juper007/radxa-zero3w-robot-hat/production/README.md

# Production

Manufacturing outputs will be stored here only after the corresponding design revision passes pre-fabrication review.

Planned outputs:

- `gerber/` - Gerber and drill files
- `bom/` - BOM exports with manufacturer part numbers
- `assembly/` - pick-and-place, assembly drawings and build notes

Every manufacturing package must state the exact design revision and commit used to generate it.
