juper007/radxa-zero3w-robot-hat/hardware/kicad/dynamixel_v17_import.sch

## KiCad design hardware/kicad/dynamixel_v17_import.sch (2026-09-10)

Schematic: dynamixel_v17_import.sch

Parts:
C_U5, C_U6, C_U7: 100n; C_0402_1005Metric
J_DXL_A: DYNAMIXEL_A; JST_EH_B3B-EH-A_1x03_P2.50mm_Vertical
J_DXL_B: DYNAMIXEL_B; JST_EH_B3B-EH-A_1x03_P2.50mm_Vertical
J_DXL_C: DYNAMIXEL_C; JST_EH_B3B-EH-A_1x03_P2.50mm_Vertical
J_IMU_DXL: IMU_TO_DXL; JST_EH_B3B-EH-A_1x03_P2.50mm_Vertical
Q1: MMBT3906; SOT-23
R26, R27, R31, R32, R34: 10k; R_0402_1005Metric
R28: 20k; R_0402_1005Metric
R33: 150R; R_0402_1005Metric
U5: 74LVC1G08; SOT-23-5
U6: SN74LVC1G125DBV; SOT-23-5
U7: SN74LVC1G126DBVR; SOT-23-5

Notes on the sheet:
DYNAMIXEL TTL V1 - corrected populated import schematic
KiCad standard 74LVC1Gxx symbol anchors independently rechecked; run KiCad 9 ERC before fabrication.
JST EH pin order remains provisional until XL330 cable orientation is physically verified.
R31 and R32 restored from upstream Pollen design. KiCad 9 ERC still required.
