juper007/radxa-zero3w-robot-hat/hardware/kicad/power_v17_import.sch

## KiCad design hardware/kicad/power_v17_import.sch (2026-09-10)

Schematic: power_v17_import.sch

Parts:
C1, C5: 470u
C2: 100u
C6, C7: 22u
C8: 1u
C9: 100n
CA1: 470u
CA2: 100u
CB1: 470u
CB2: 100u
CC1: 470u
CC2: 100u
C_DVDT: 3.9n
C_U1_IN: 22n
C_U1_OUT: 100n
C_VCAP: 100n
F1: 20A
J1: XT60_IN; Conn_01x02
J2: SERVO_A_PWR
J3: SERVO_B_PWR
J4: SERVO_C_PWR
J40_PWR: RADXA_PWR_IF
NTA: SERVO_A_COPPER_TIE; HighCurrent_NetTie_2Pin_8mm
NTB: SERVO_B_COPPER_TIE; HighCurrent_NetTie_2Pin_8mm
NTC: SERVO_C_COPPER_TIE; HighCurrent_NetTie_2Pin_8mm
Q1: BSC009NE2LS5I; Infineon_PG-TDSON-8_SuperSO8
R_EN: 390k
R_ILIM: 825R
R_OV_BOTTOM: 100k
R_OV_TOP: 374k
U1: LM74700QDBVRQ1; SOT-23-6
U2: TPS259470ARPWR; TI_RPW0010A_2x2mm_P0.45mm

Notes on the sheet:
POWER V1 - validation-corrected populated import schematic
Servo branches use NTA/NTB/NTC copper net ties; no generic zero-ohm branch resistors.
NTA/NTB/NTC are PCB copper net ties using RadxaRobotHat:HighCurrent_NetTie_2Pin_8mm; they are not BOM resistors.
Power/current integrity, exact net-tie current path, connector/fuse mechanics and real KiCad 9 ERC/DRC remain mandatory before fabrication.
