juper007/radxa-zero3w-robot-hat/(commit log)

2026-09-10 Add Radxa ZERO 3W pin mapping
2026-09-10 Add detailed V1 power subsystem design
2026-09-10 Add KiCad power sheet implementation specification
2026-09-10 Add provisional V1 power BOM
    [power_v1_bom.csv]
2026-09-10 Advance project status to Phase 1 power design
2026-09-10 Add XL330 and system power current budget
2026-09-10 Revise V1 power architecture for 5V XL330 system bus
2026-09-10 Revise power BOM for 5V high-current XL330 architecture
    [power_v1_bom.csv]
2026-09-10 Add V1 power component selection document
2026-09-10 Update status with 5V architecture and current budget decisions
2026-09-10 docs: add high-current layout and main protection design
2026-09-10 docs: freeze main input protection and connector choices
2026-09-10 hardware: add V1 power connectivity table
    [power_v1_connectivity.csv]
2026-09-10 docs: advance power design to component-lock stage
2026-09-10 Freeze V1 power schematic values and TPS25947 settings
2026-09-10 Freeze power connectivity values for schematic implementation
    [power_v1_connectivity.csv]
2026-09-10 Add initial KiCad 9 power schematic source skeleton
    [power.kicad_sch]
2026-09-10 Update hardware status after adding power schematic source
2026-09-10 Advance power design to v0.5-dev
2026-09-10 fix LM74700 external MOSFET source drain orientation
    [power_v1_connectivity.csv]
2026-09-10 add verified power IC KiCad symbols
2026-09-10 correct LM74700 DBV 6-pin symbol pin mapping
2026-09-10 register project power symbol library
2026-09-10 add automated power connectivity sanity checker
2026-09-10 document verified power pinouts and library review
2026-09-10 add CI sanity check for power connectivity
2026-09-10 advance power design to v0.6-dev with verified pin maps and CI
2026-09-10 rewrite power sheet spec for 5V high-current architecture
2026-09-10 add Dynamixel V1 connectivity contract
    [dynamixel_v1_connectivity.csv]
2026-09-10 add first Dynamixel V1 BOM
    [dynamixel_v1_bom.csv]
2026-09-10 synchronize power BOM with frozen V1 parts and values
    [power_v1_bom.csv]
2026-09-10 add power footprint verification gate
2026-09-10 add KiCad 9 Dynamixel implementation skeleton
    [dynamixel.kicad_sch]
2026-09-10 advance to v0.8-dev after Dynamixel recovery and BOM sync
2026-09-10 add TI RPW0010A manufacturer land pattern footprint
2026-09-10 add symbol-matching TPS25947 RPW footprint alias
2026-09-10 register project footprint library
2026-09-10 add footprint geometry sanity checker
2026-09-10 add footprint geometry CI check
2026-09-10 record TPS25947 footprint transcription and Infineon package variant
2026-09-10 correct upstream Dynamixel TTL buffer direction mapping
    [dynamixel_v1_connectivity.csv]
2026-09-10 correct Dynamixel schematic contract TX RX roles
    [dynamixel.kicad_sch]
2026-09-10 define current MicroDuck sensor architecture
2026-09-10 add V1 sensor and I2C connectivity contract
    [sensors_v1_connectivity.csv]
2026-09-10 add sensor connectivity sanity checker
2026-09-10 add sensor architecture CI check
2026-09-10 add sensor and I2C KiCad implementation skeleton
    [sensors.kicad_sch]
2026-09-10 add V1 audio connectivity contract
    [audio_v1_connectivity.csv]
2026-09-10 add audio KiCad implementation skeleton
    [audio.kicad_sch]
2026-09-10 add top-level V1 integration connectivity contract
    [top_level_v1_connectivity.csv]
2026-09-10 add top-level KiCad integration skeleton
    [main.kicad_sch]
2026-09-10 advance project to v0.10-dev with sensor audio and top-level contracts
2026-09-10 verify complementary Dynamixel OE net and R33 placement
    [dynamixel_v1_connectivity.csv]
2026-09-10 sync Dynamixel BOM with recovered upstream direction circuit
    [dynamixel_v1_bom.csv]
2026-09-10 advance to v0.11-dev after Dynamixel OE and Q1 footprint corrections
2026-09-10 freeze recovered Dynamixel auto-direction generator
    [dynamixel_v1_connectivity.csv]
2026-09-10 freeze Dynamixel direction generator BOM roles
    [dynamixel_v1_bom.csv]
2026-09-10 document fully recovered Dynamixel auto-direction circuit
2026-09-10 synchronize Dynamixel KiCad implementation contract with recovered topology
    [dynamixel.kicad_sch]
2026-09-10 correct BSC009 package identification and lock manufacturer boardpad source
2026-09-10 freeze TTL-only U5 idle-high bias for RS485 DNP
    [dynamixel_v1_connectivity.csv]
2026-09-10 add TTL-only RS485 idle bias to Dynamixel BOM
    [dynamixel_v1_bom.csv]
2026-09-10 add manufacturer-derived BSC009 footprint implementation spec
2026-09-10 advance to v0.13-dev after RS485 DNP bias freeze and BSC footprint correction
2026-09-10 add Infineon PG-TDSON-8 SuperSO8 footprint for BSC009
2026-09-10 extend footprint CI to BSC009 SuperSO8
2026-09-10 record BSC009 SuperSO8 footprint implementation and CI pass
2026-09-10 advance to v0.14-dev after BSC009 footprint implementation
2026-09-10 add electrically populated Dynamixel import schematic
    [dynamixel_v15_import.sch]
2026-09-10 fix Dynamixel import schematic pin anchors and power pins
    [dynamixel_v15_import.sch]
2026-09-10 add Dynamixel populated schematic structure checker
2026-09-10 run populated Dynamixel schematic structure check in CI
2026-09-10 add populated power V1 KiCad import schematic
    [power_v16_import.sch]
2026-09-10 add populated power schematic structure checker
2026-09-10 run populated power schematic structure check in CI
2026-09-10 fix power schematic checker false-positive on no-buck declaration
2026-09-10 advance project status to v0.16 populated power and Dynamixel schematics
2026-09-10 fix Dynamixel logic power and OE pin anchors after validation review
    [dynamixel_v17_import.sch]
2026-09-10 validate corrected Dynamixel power and OE pin anchors
2026-09-10 run Dynamixel CI on validation-corrected v17 schematic
2026-09-10 fix Dynamixel symbol anchors and restore R31/R32 pull-ups
    [dynamixel_v17_import.sch]
2026-09-10 restore upstream R31 and R32 Dynamixel pull-ups in connectivity contract
    [dynamixel_v1_connectivity.csv]
2026-09-10 add R31 and R32 upstream Dynamixel pull-ups to BOM
    [dynamixel_v1_bom.csv]
2026-09-10 add 8mm high-current copper net-tie footprint for servo branches
2026-09-10 replace servo 0-ohm branch links with high-current copper net ties
    [power_v1_connectivity.csv]
2026-09-10 replace unverified 2512 zero-ohm branch links with copper net ties in BOM
    [power_v1_bom.csv]
2026-09-10 enforce copper net ties and reject zero-ohm servo branch links
2026-09-10 extend footprint CI to high-current servo copper net tie
2026-09-10 correct BSC009 package variant and document high-current servo net-tie fix
2026-09-10 add v0.17 power import schematic with high-current copper net ties
    [power_v17_import.sch]
2026-09-10 validate v17 power import schematic and high-current servo net ties
2026-09-10 run power CI against validation-corrected v17 schematic
2026-09-10 mark validation-corrected power v17 draft as current
2026-09-10 make v17 power schematic CI validate electrical intent instead of brittle coordinates
2026-09-10 fix v17 net-tie footprint assignment CI count
